BenLee1118/Egg_Incubator/Egg_Incubator.jpg

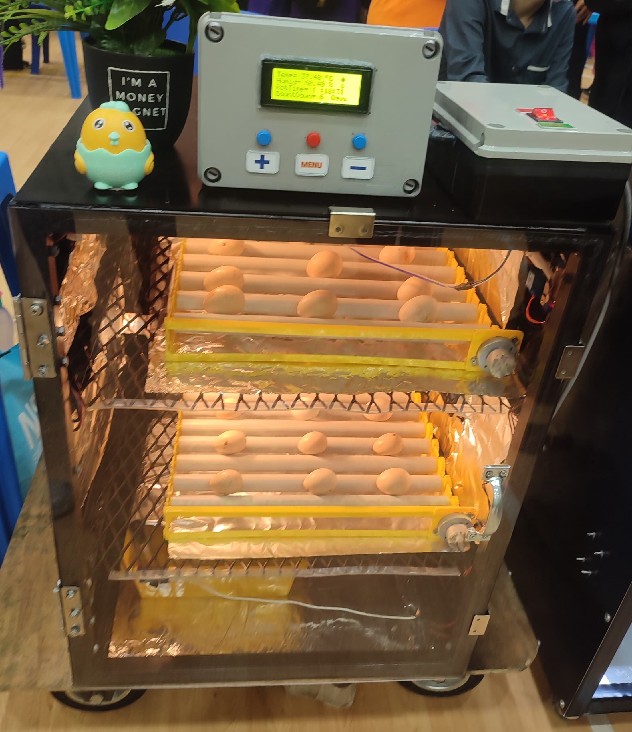
Egg_Incubator.jpg
