BenLee1118/Egg_Incubator/Design_Book_Resources/Minute Meeting.xlsx

No | Date | Activity | Involvement
1 | 2023-04-03 | Designing of electric circuit in proteus | B + C
2 | 2023-04-06 | Borrow of raw materials in Machining Lab | A + B + C + D + E
3 | 2023-04-12 | Measuring and cutting process of the mild steel sheet, hollow mild steel, and angle bar | C + D + E
4 | 2023-04-12 | Borrow of electrical components | A + B + C + D + E | Wong = A
5 | 2023-04-27 | Buying of electrical components | B + C + D | Ben = B
6 | 2023-04-28 | Code for LCD to display introduction & slogan | B | Syahril = C
7 | 2023-04-29 | Code for LCD to show the menu | B | Nivya = D
8 | 2023-05-01 | Code for receving data from DHT22 Sensor & triggered Buzzer under specific conditions | B + C | Iqbal = E
9 | 2023-05-02 | Code for conditions that triggered the bulb | B
10 | 2023-05-03 | Code for conditions that triggered the Humidifier | B + C
11 | 2023-05-04 | Code for conditions that triggered the Fan | B + C
12 | 2023-05-07 | Code for the system to countdown from hours, minutes and seconds | B
13 | 2023-05-08 | Code for conditions that triggered the Motor and rotation duration | B + C
14 | 2023-05-10 | Assemble and tack weld the hollow mild steel and angled bar as the frame of the machine | C + D + E
15 | 2023-05-10 | Code for system to follow real time clock | B
16 | 2023-05-11 | Code for the system to countdown from days | B
17 | 2023-05-12 | MIG full weld the whole frame | C + D + E
18 | 2023-05-13 | Code for the system to memorize the address and data | B
19 | 2023-05-14 | Testing simulation between arduino code and proteus | B
20 | 2023-05-17 | Grind the excess weld pool on the frame | C + D + E
21 | 2023-05-17 | Building of simple connections for each components | B + C
22 | 2023-05-17 | Testing of the functionality of all the components by running with new created simple coding | B + C
23 | 2023-05-18 | Join and weld the mild steel sheet as the base of the machine | B + C + D + E
24 | 2023-05-23 | Repeat of building simple connections for each components and run it with simple codes | B + C
25 | 2023-05-24 | Solving for one of the malfunction components and testing of components for checking confirmation | B + C
26 | 2023-05-24 | Connection of all the components and run it with finalize arduino code to check the whole system of our circuit. | B + C + D + E
27 | 2023-05-25 | Welding the mild steel sheet as the base of the machine along with the frame. | C + D + E
28 | 2023-05-26 | Grinding process on the welded parts | C + D + E
29 | 2023-05-27 | Tack welds the wire mesh and the frame together. | C + D + E
30 | 2023-05-27 | Drilling process on the body frame | B + C + D + E
31 | 2023-05-27 | Coating process for the frame of the machine | C + D + E
32 | 2023-05-27 | Laser cutting process for the acrylic sheet. | B + C + D + E
33 | 2023-05-27 | Installation of the acrylic sheet | B + C + D + E
34 | 2023-05-28 | Installation of the cooling fan | B + C + D + E
35 | 2023-05-28 | Assembly and installation of the bulb holder and bulb | B + C + D + E
36 | 2023-05-28 | Assembly and installation of the egg roller tray | B + C + D + E
37 | 2023-05-28 | Installation of the water tray and humidifier | B + C + D + E
39 | 2023-05-28 | Joining and managing the electrical part with the machine | B + C + D + E
40 | 2023-05-28 | Upload of the programming | B + C + D + E
41 | 2023-05-30 | Assembly of the door | B + C + D + E
42 | 2023-05-30 | Apply the silicone sealant between the gaps between the acrylic sheet and the frame. | B + C + D + E
43 | 2023-06-30 | Programming of codes for ESP8266 | B
44 | 2023-06-30 | Designing the GUI of mobile device for the machine | B
45 | 2023-06-01 | Installtion of ESP8266 and wifi modem on the machine | B + C
46 | 2023-06-01 | Final testing after the eggs have been placed. | A + B + C + D + E
