BenLee1118/Egg_Incubator/Design_Book_Resources/IDP_B&W_Circuit.bmp

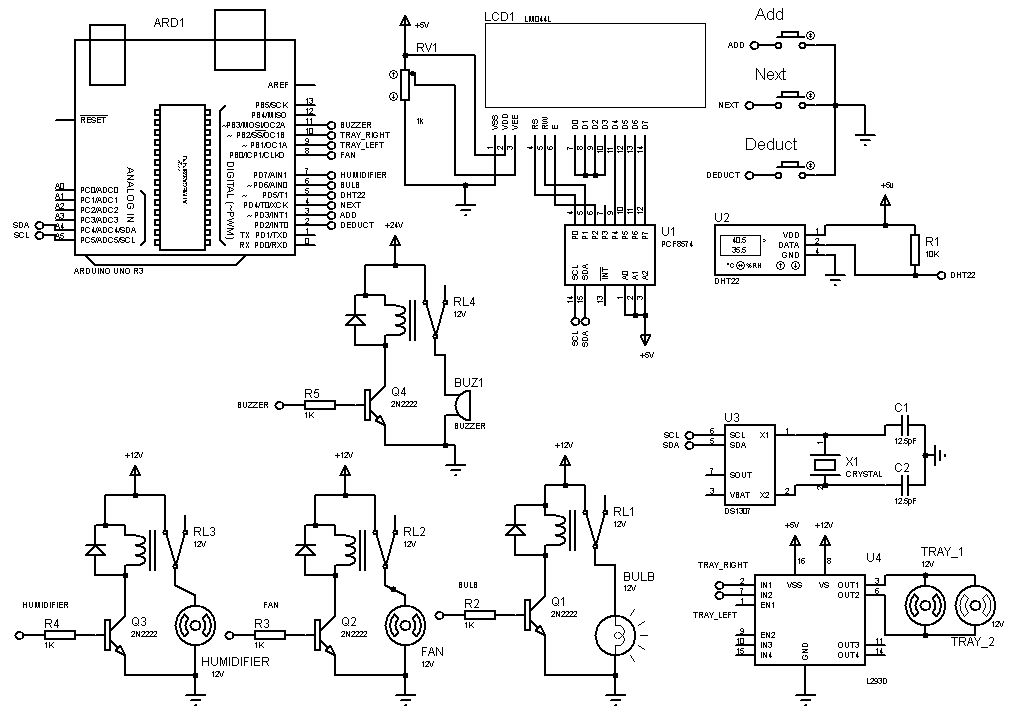
Design_Book_Resources/IDP_B&W_Circuit.bmp
