BenLee1118/Egg_Incubator/Design_Book_Resources/IDP_BlockDiagram.png

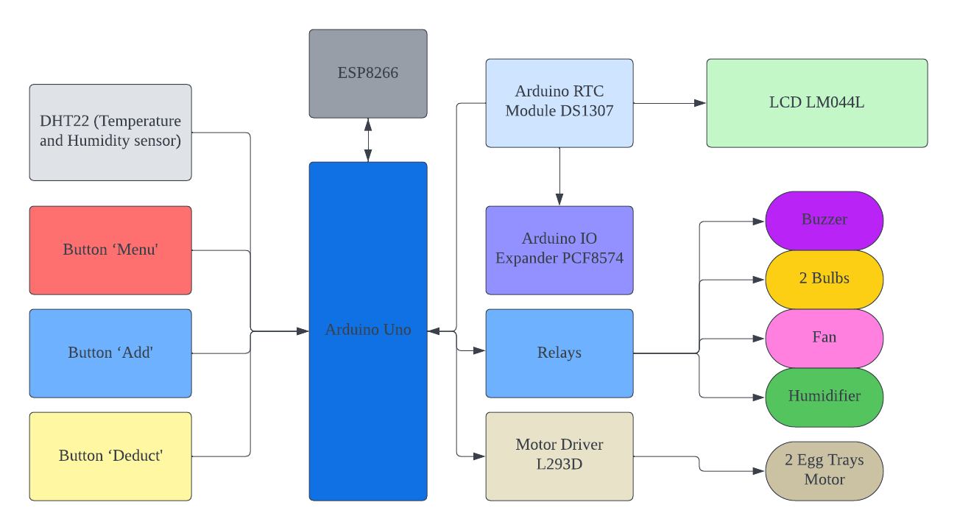
Design_Book_Resources/IDP_BlockDiagram.png
