BenLee1118/Egg_Incubator/Design_Book_Resources/IDP_Circuit_Fritzing.png

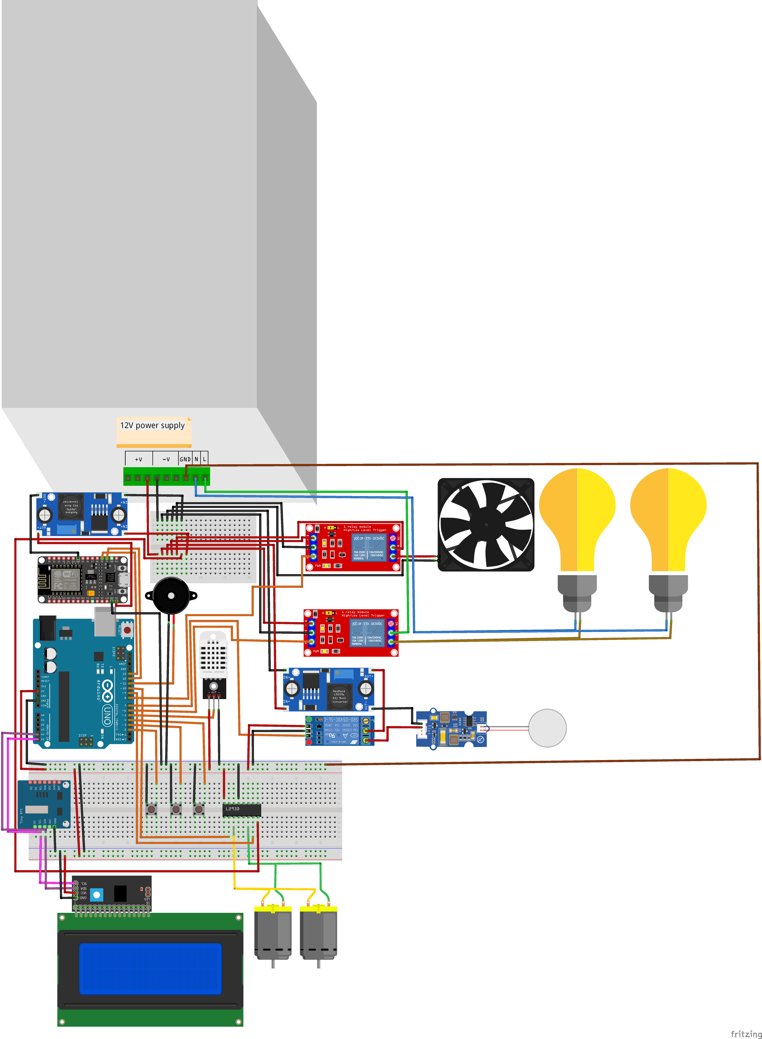
Design_Book_Resources/IDP_Circuit_Fritzing.png
