BenLee1118/Egg_Incubator/Design_Book_Resources/IDP_Circuit_Fritzing_Cropped.png

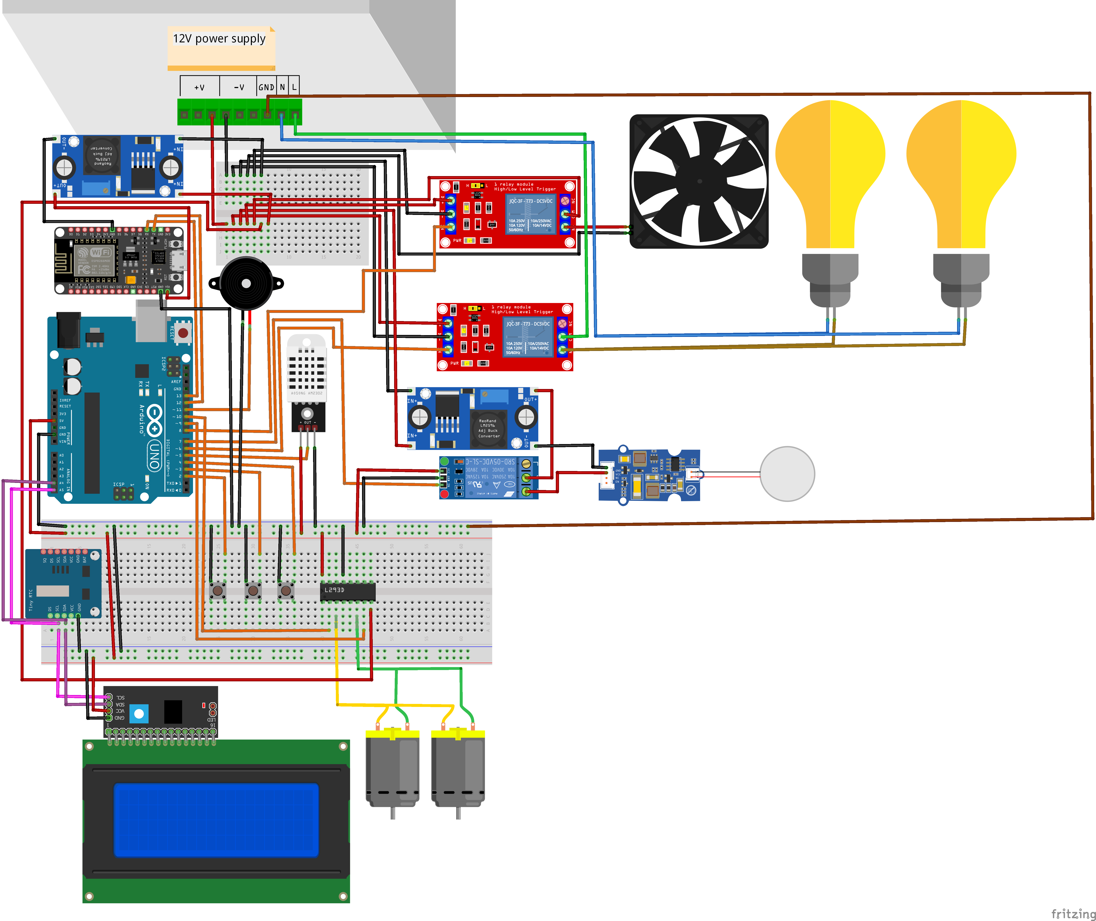
Design_Book_Resources/IDP_Circuit_Fritzing_Cropped.png
