BenLee1118/Egg_Incubator/Design_Book_Resources/IDP_FlowChart_GUI.png

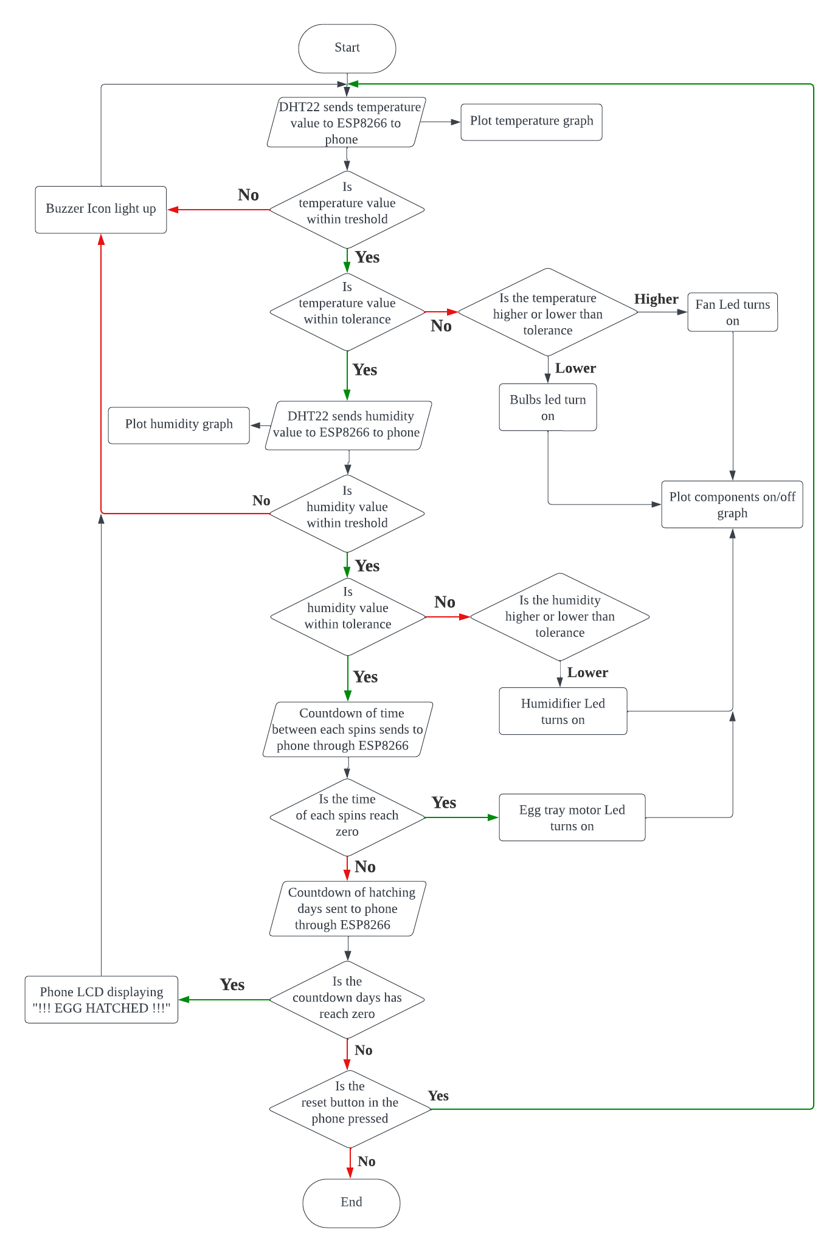
Design_Book_Resources/IDP_FlowChart_GUI.png
