BenLee1118/Egg_Incubator/Design_Book_Resources/IDP_FlowChart_Sensors.png

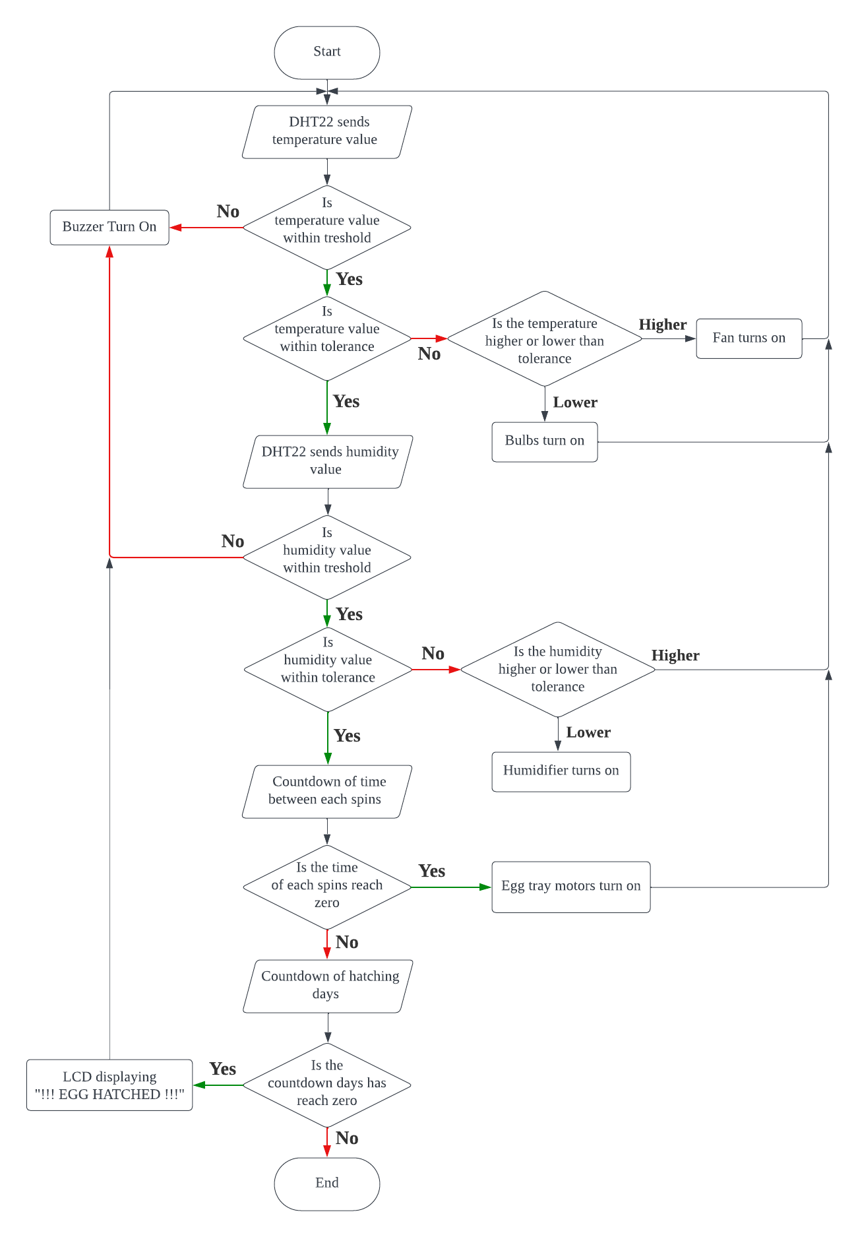
Design_Book_Resources/IDP_FlowChart_Sensors.png
