BenLee1118/Egg_Incubator/Design_Book_Resources/IDP_FlowChart_Settings_1.png

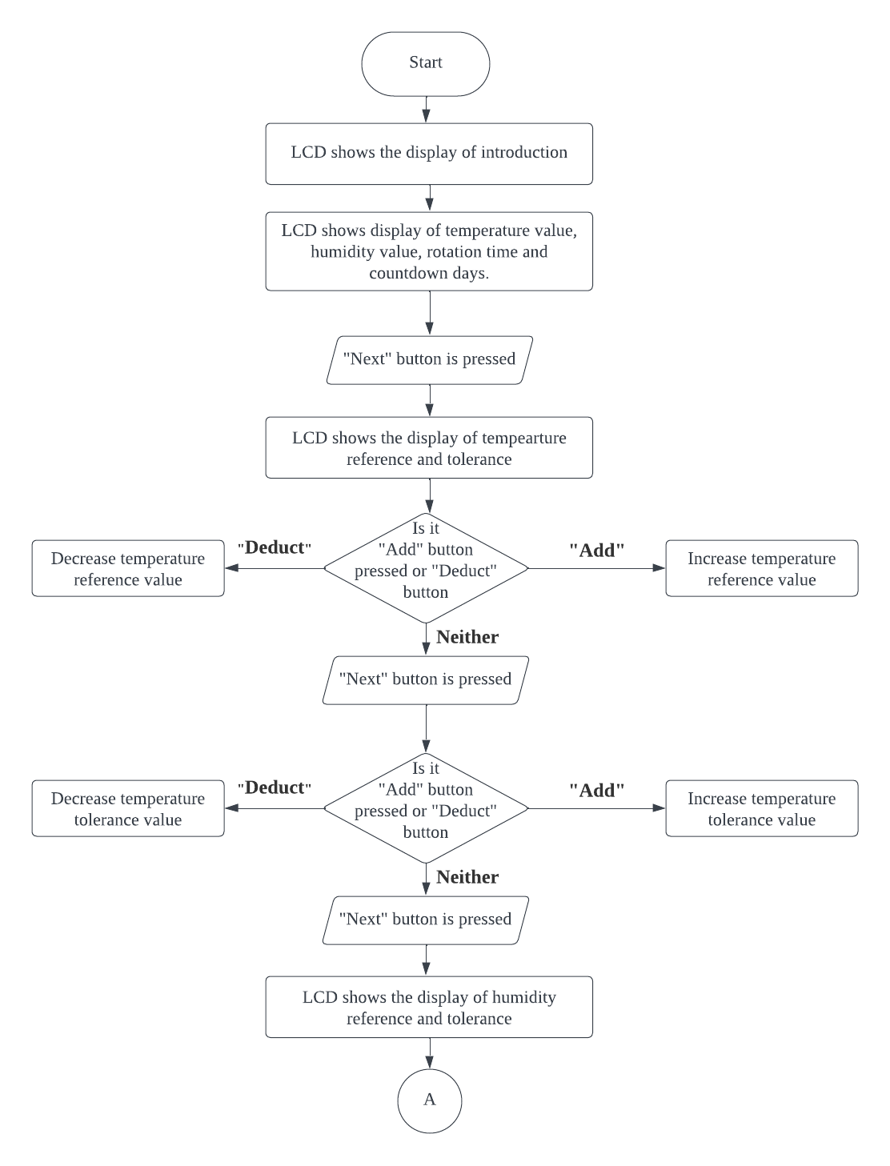
Design_Book_Resources/IDP_FlowChart_Settings_1.png
