BenLee1118/Egg_Incubator/Design_Book_Resources/IDP_FlowChart_Settings_3.png

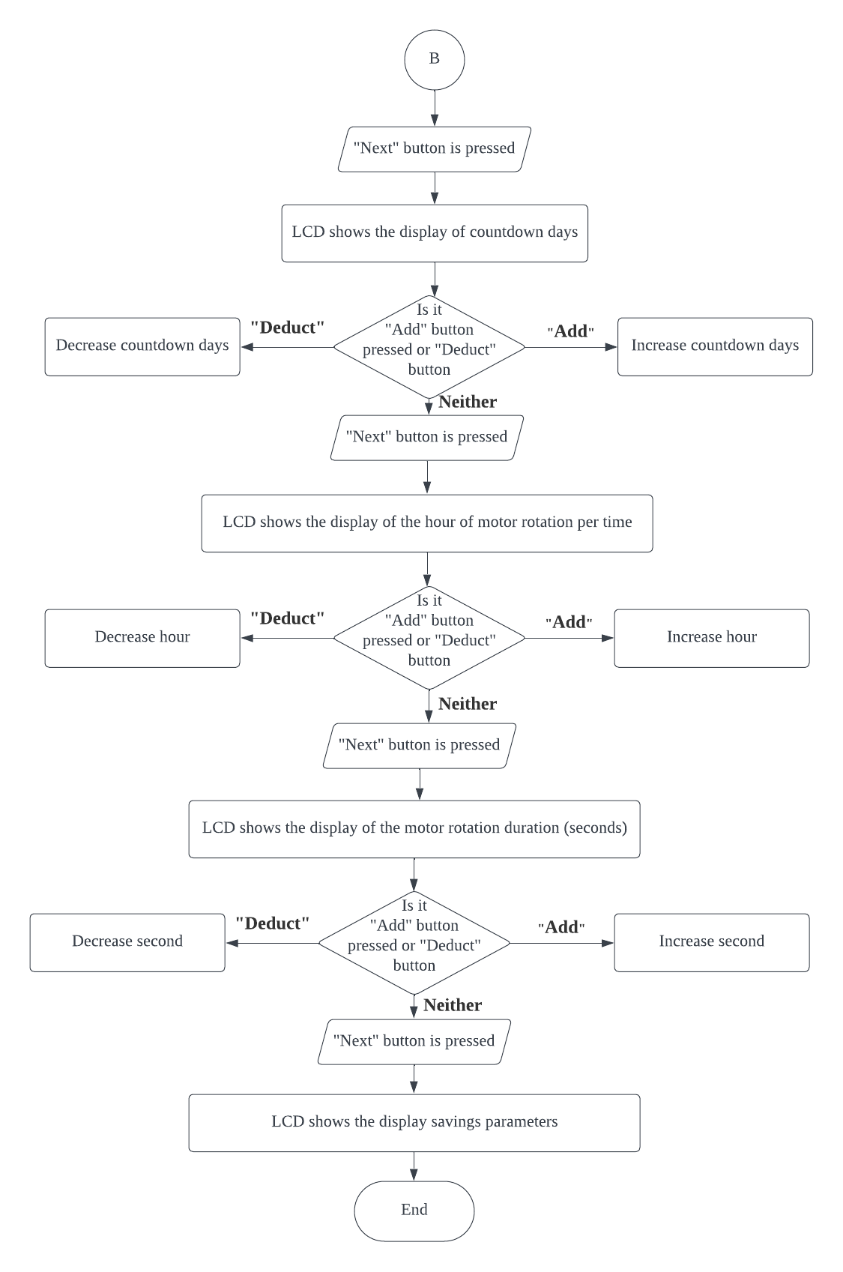
Design_Book_Resources/IDP_FlowChart_Settings_3.png
