BenLee1118/Egg_Incubator/Design_Book_Resources/IDP_GUI_1.jpg

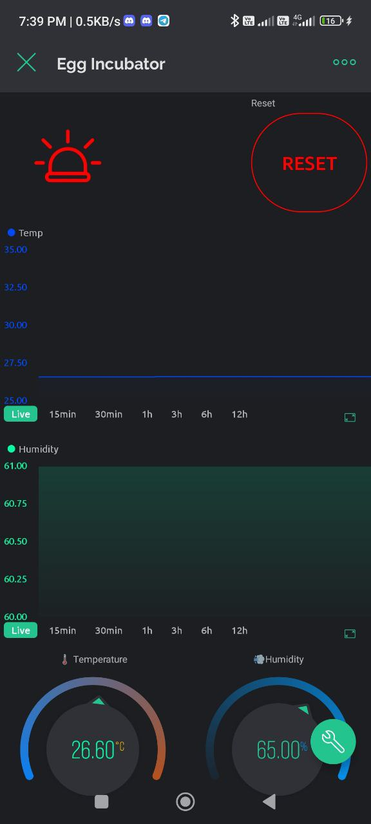
Design_Book_Resources/IDP_GUI_1.jpg
