BenLee1118/Egg_Incubator/IoT_EggIncubator.png

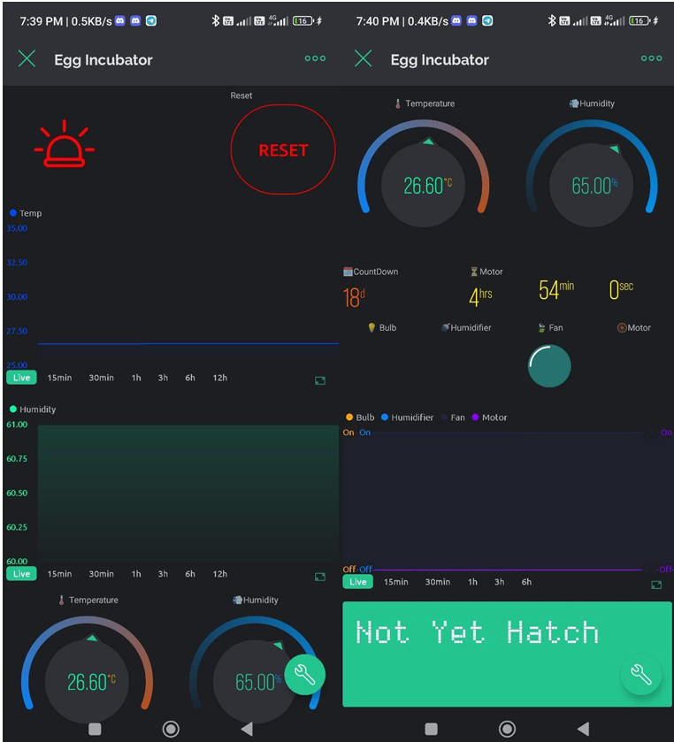
IoT_EggIncubator.png
