BenLee1118/Egg_Incubator/Design_Book_Resources/IDP_list.xlsx

Numbers | Components | Quantity
1 | LCD LM044L 20x4 | 1 | shopee
2 | Potentiometer 1k Ohm | 3 | shopee
3 | Push Buttons | 3 | shopee
4 | PCF8574 I2C LCD (extrenal io port) | 1 | shopee
5 | DS1307 (Real Time Clock) | 1 | shopee
6 | Capacitor 12.5pF | 2
7 | Humidifier | 1 | shopee
8 | Bulb | 1
9 | Fan | 1 | shopee
10 | Buzzer | 1 | shopee
11 | DHT22 | 1 | shopee
12 | Motor Driver L293D | 1 | shopee
13 | Resistor 10k Ohm | 1 | shopee
14 | Resistor 1k Ohm | 4 | Have
15 | Diode 1N4001 | 4 | shopee
16 | Transistor 2N2222 | 4 | shopee
17 | Relays | 5
