BenLee1118/Egg_Incubator/(list of files, drawings)

Other design files:
Project/IDP_Proteus/Ben_IDP/EHM_BenLee_Uno.pdsprj
Project/IDP_Proteus/Ben_IDP/Project Backups/EHM_BenLee_Uno [20230520, 17-12-31].pdsprj
Project/IDP_Proteus/Ben_IDP/Project Backups/EHM_BenLee_Uno [20230625, 23-03-31].pdsprj
